jeffraines/sortbuddy/docs/build/print/belt_frame.stl

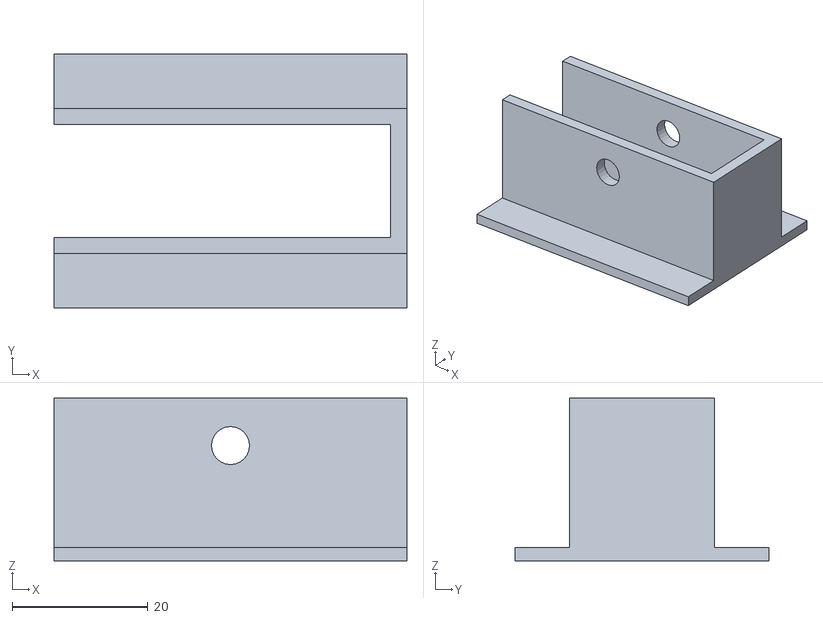
[picture p1: CAD file, 2026-11-09]
docs/build/print/belt_frame.stl
52.0 x 37.4 x 24.0
