jeffraines/sortbuddy/docs/build/print/belt_spacer.stl

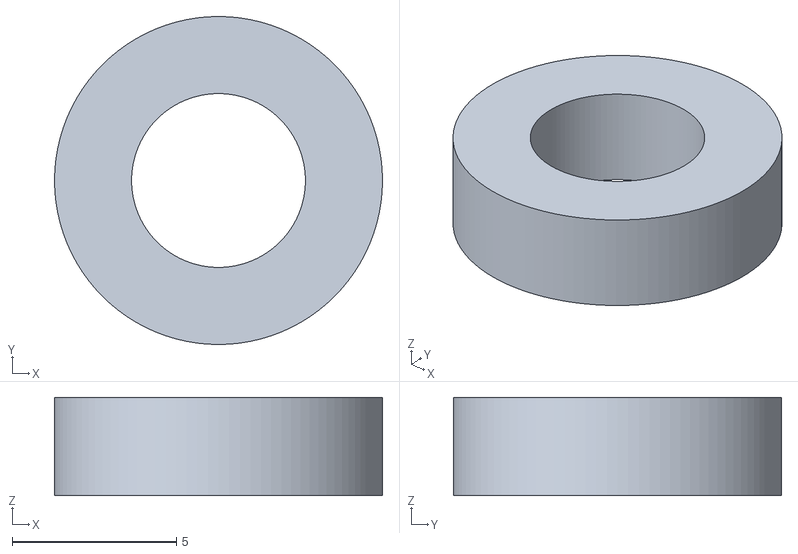
[picture p2: CAD file, 2026-11-07]
docs/build/print/belt_spacer.stl
10.0 x 10.0 x 3.00
