jeffraines/sortbuddy/docs/build/print/belt_axle.stl

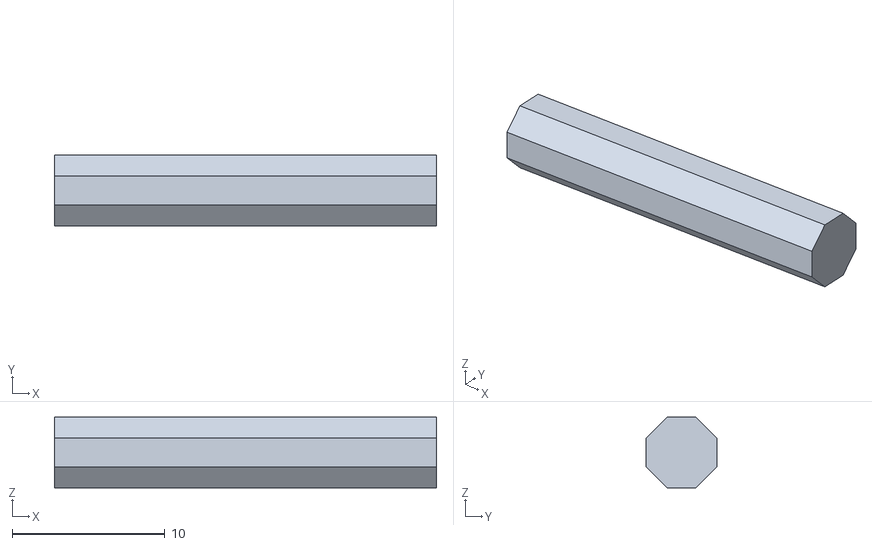
[picture p3: CAD file, 2026-11-07]
docs/build/print/belt_axle.stl
25.0 x 4.62 x 4.62
