jeffraines/sortbuddy/docs/build/print/belt_wheel_feed.stl

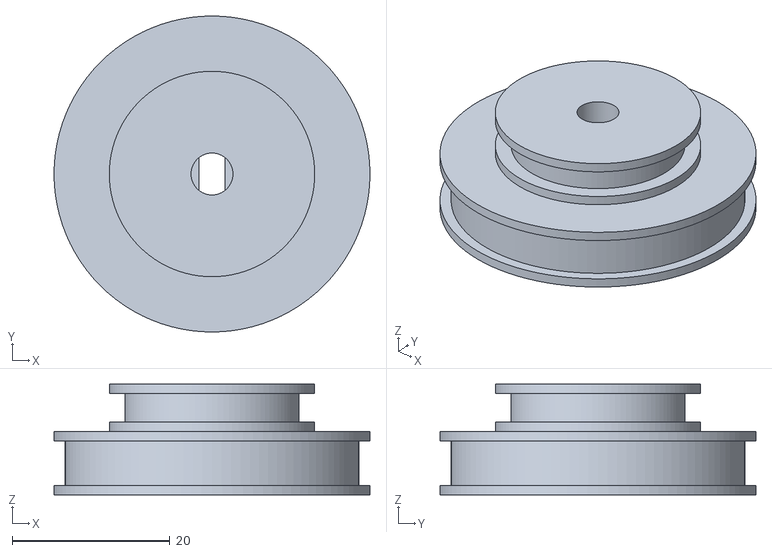
[picture p4: CAD file, 2026-11-07]
docs/build/print/belt_wheel_feed.stl
40.0 x 40.0 x 14.0
