jeffraines/sortbuddy/docs/build/print/takeaway_rollers.stl

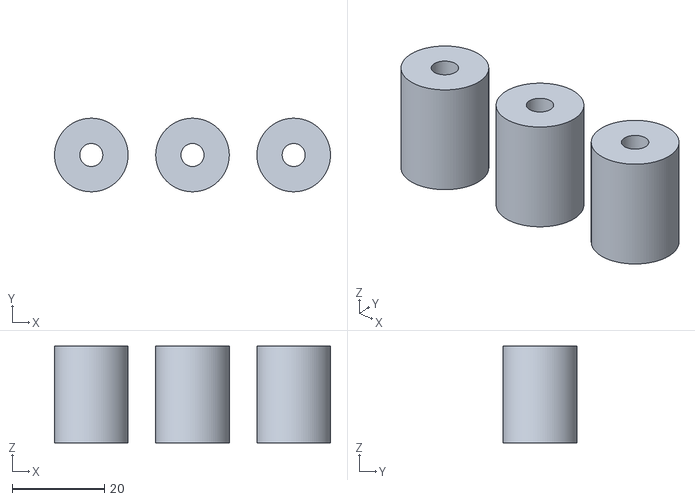
[picture p5: CAD file, 2026-11-07]
docs/build/print/takeaway_rollers.stl
60.0 x 16.0 x 21.0
