jeffraines/sortbuddy/docs/build/print/slide_takeaway_lite.stl

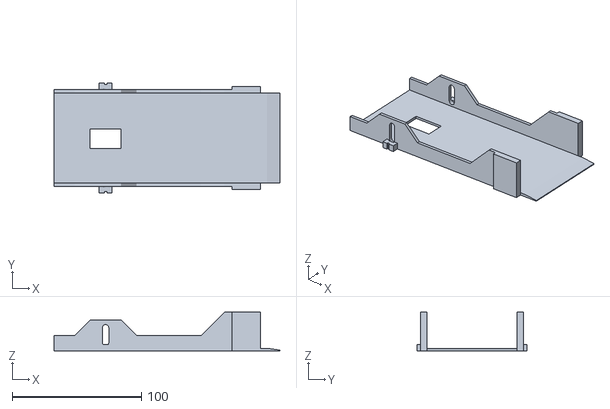
[picture p6: CAD file, 2026-11-07]
docs/build/print/slide_takeaway_lite.stl
175.0 x 84.8 x 30.0
