jeffraines/sortbuddy/docs/build/print/takeaway_bracket.stl

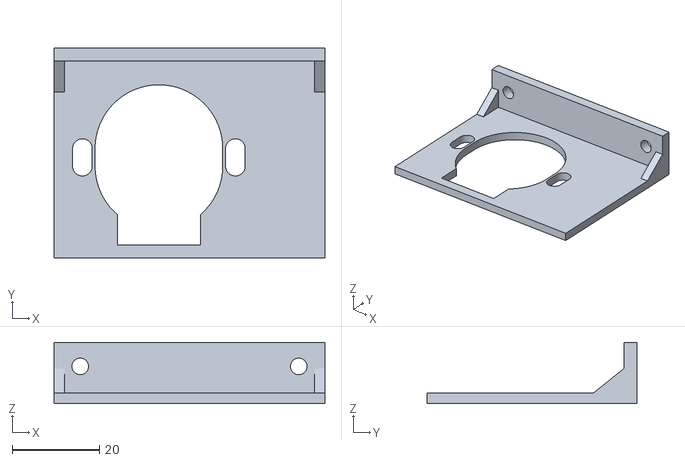
[picture p7: CAD file, 2026-11-07]
docs/build/print/takeaway_bracket.stl
62.0 x 48.0 x 14.0
