jeffraines/sortbuddy/docs/build/print/takeaway_axle.stl

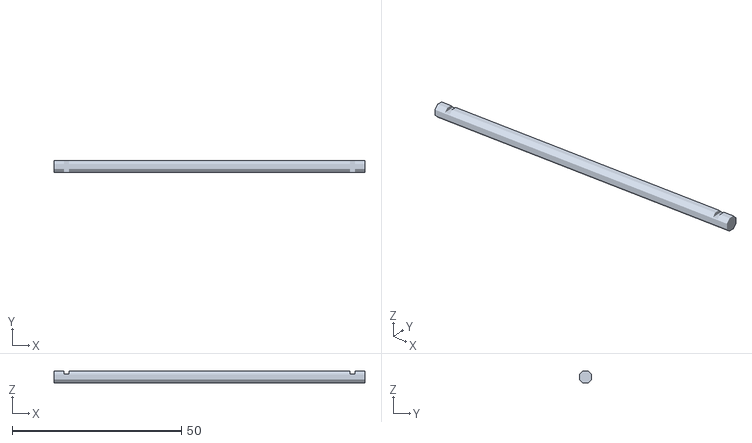
[picture p8: CAD file, 2026-11-07]
docs/build/print/takeaway_axle.stl
92.0 x 3.70 x 3.70
