jeffraines/sortbuddy/docs/build/print/takeaway_roller.stl

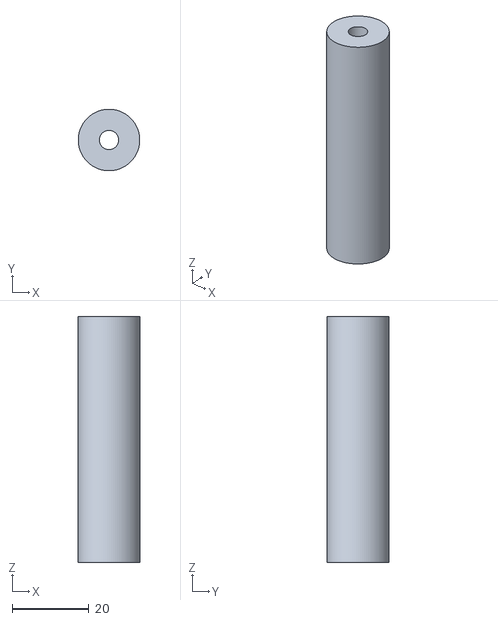
[picture p9: CAD file, 2026-11-07]
docs/build/print/takeaway_roller.stl
16.0 x 16.0 x 64.0
