jeffraines/sortbuddy/docs/build/print/bracket_lite.stl

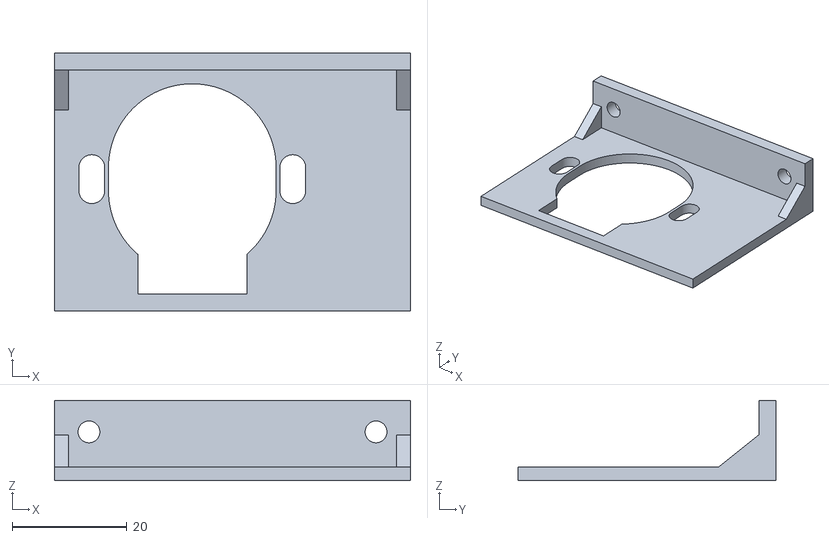
[picture p10: CAD file, 2026-11-07]
docs/build/print/bracket_lite.stl
62.0 x 45.0 x 14.0
