jeffraines/sortbuddy/docs/build/print/slide_takeaway.stl

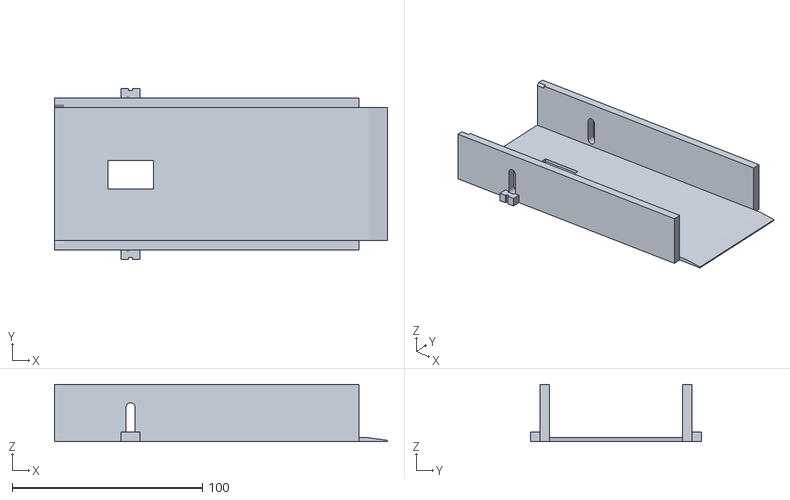
[picture p11: CAD file, 2026-11-07]
docs/build/print/slide_takeaway.stl
175.0 x 90.0 x 30.0
