jeffraines/sortbuddy/docs/build/print/hopper_frame.stl

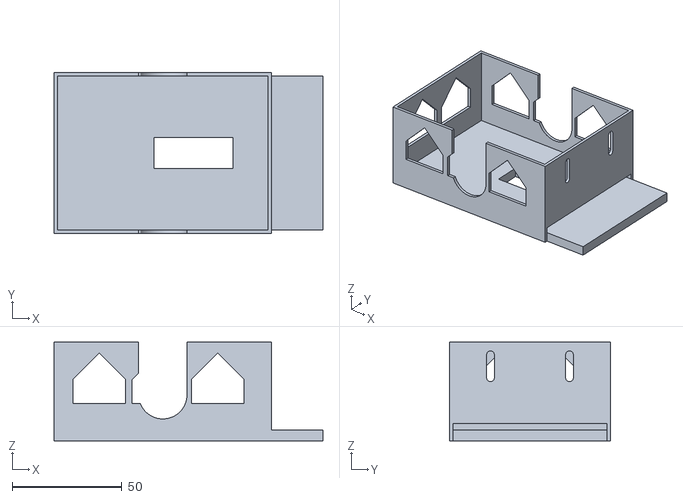
[picture p12: CAD file, 2026-11-07]
docs/build/print/hopper_frame.stl
122.6 x 73.2 x 45.0
