jeffraines/sortbuddy/docs/build/print/hopper.stl

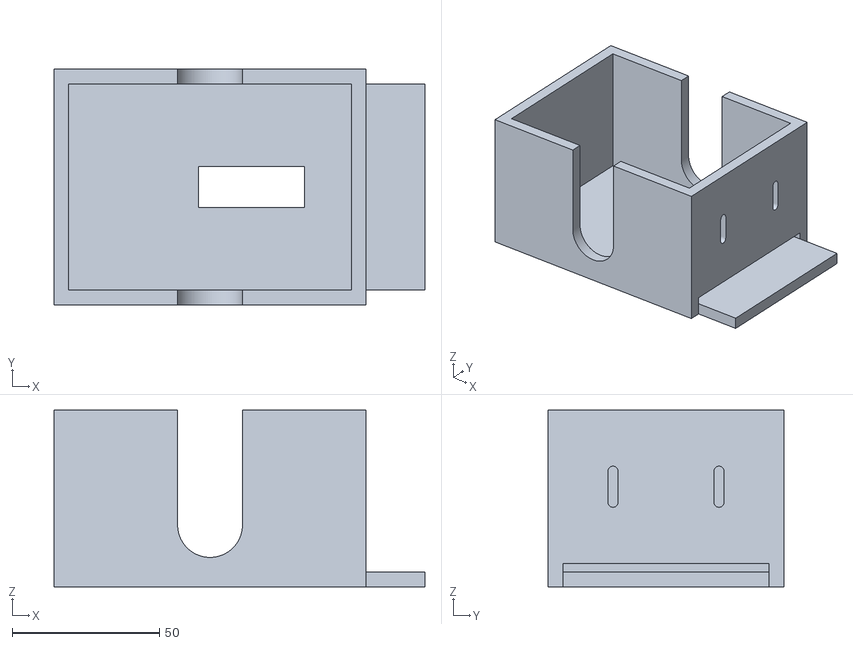
[picture p13: CAD file, 2026-11-07]
docs/build/print/hopper.stl
126.0 x 80.0 x 60.0
