jeffraines/sortbuddy/docs/build/print/hopper_light.stl

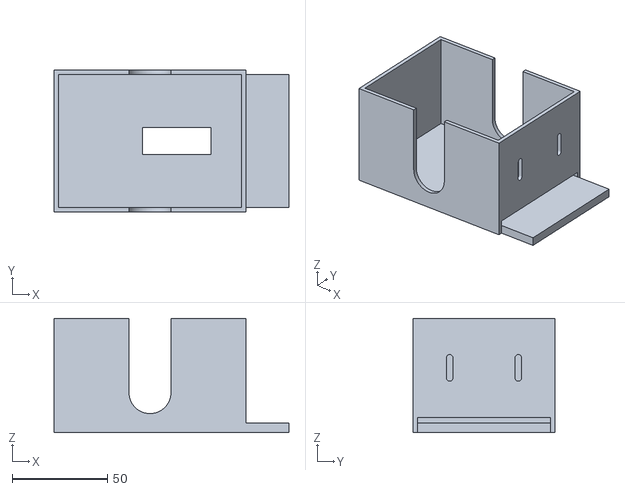
[picture p14: CAD file, 2026-11-07]
docs/build/print/hopper_light.stl
123.4 x 74.8 x 60.0
