jeffraines/sortbuddy/docs/build/print/wheel_spaced.stl

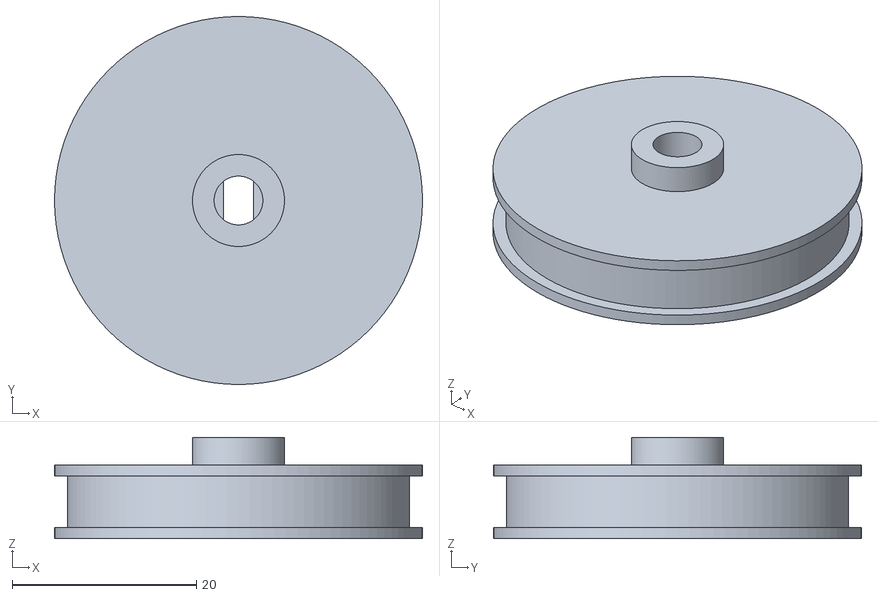
[picture p15: CAD file, 2026-11-07]
docs/build/print/wheel_spaced.stl
40.0 x 40.0 x 11.0
