jeffraines/sortbuddy/docs/build/print/wheel_lite.stl

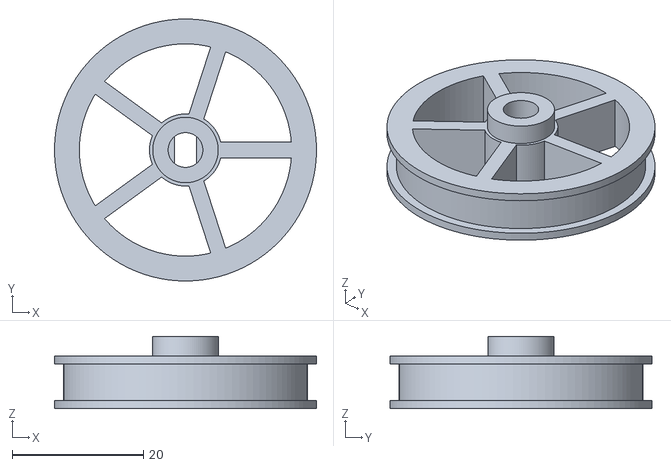
[picture p16: CAD file, 2026-11-07]
docs/build/print/wheel_lite.stl
40.0 x 40.0 x 11.0
