jeffraines/sortbuddy/docs/build/print/bracket.stl

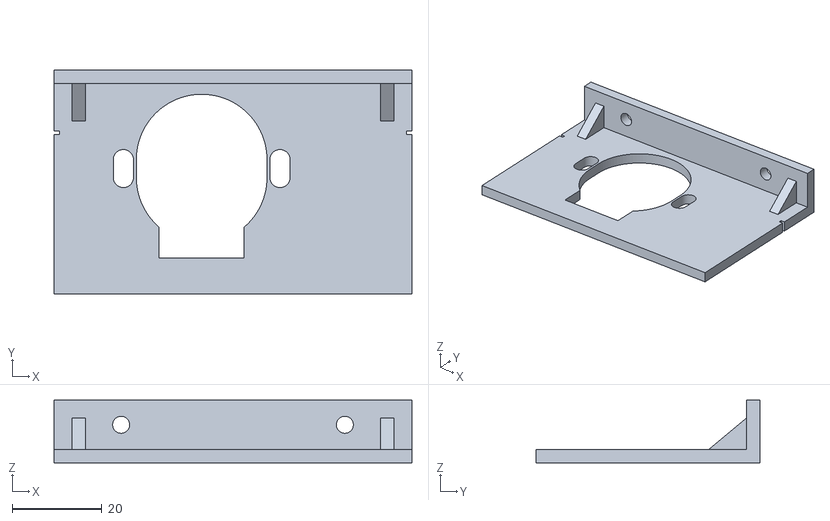
[picture p17: CAD file, 2026-11-07]
docs/build/print/bracket.stl
80.0 x 50.0 x 14.0
