jeffraines/sortbuddy/docs/build/print/panel_D.stl

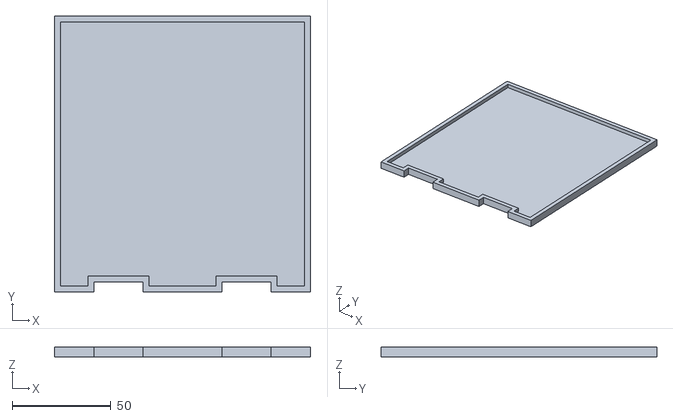
[picture p18: CAD file, 2026-11-07]
docs/build/print/panel_D.stl
130.0 x 140.0 x 5.00
