jeffraines/sortbuddy/docs/build/print/plate_F.stl

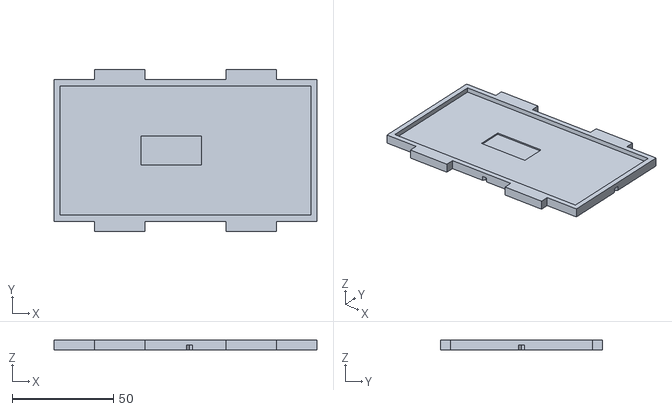
[picture p19: CAD file, 2026-11-07]
docs/build/print/plate_F.stl
130.0 x 80.0 x 5.00
