jeffraines/sortbuddy/docs/build/print/joints.stl

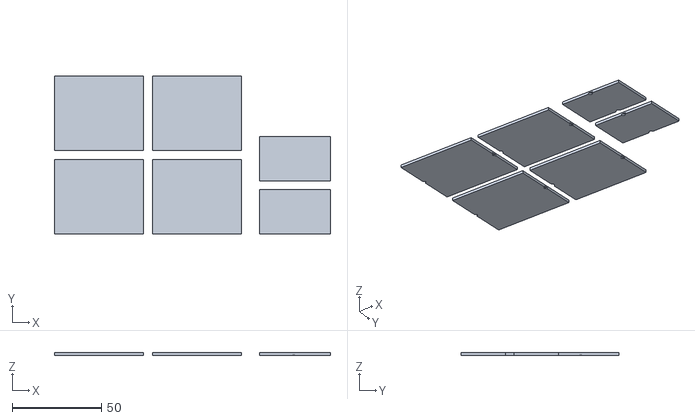
[picture p20: CAD file, 2026-11-07]
docs/build/print/joints.stl
155.0 x 89.0 x 1.60
