jeffraines/sortbuddy/docs/build/print/joiner.stl

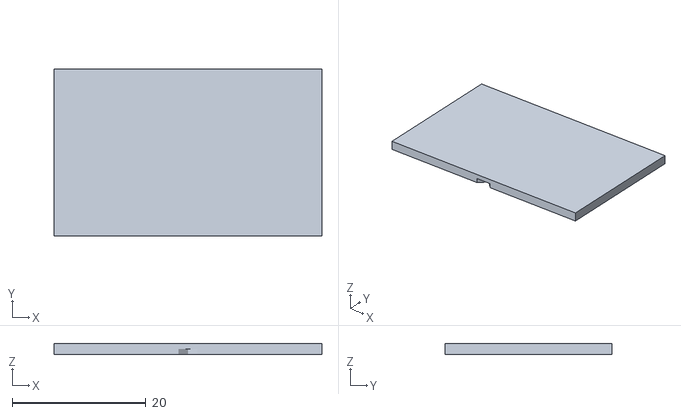
[picture p21: CAD file, 2026-11-07]
docs/build/print/joiner.stl
40.0 x 25.0 x 1.60
