jeffraines/sortbuddy/docs/build/print/splice.stl

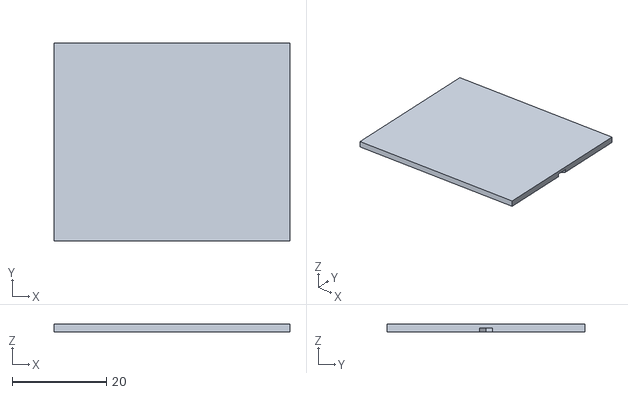
[picture p22: CAD file, 2026-11-07]
docs/build/print/splice.stl
50.0 x 42.0 x 1.60
