jeffraines/sortbuddy/docs/build/print/led_channel.stl

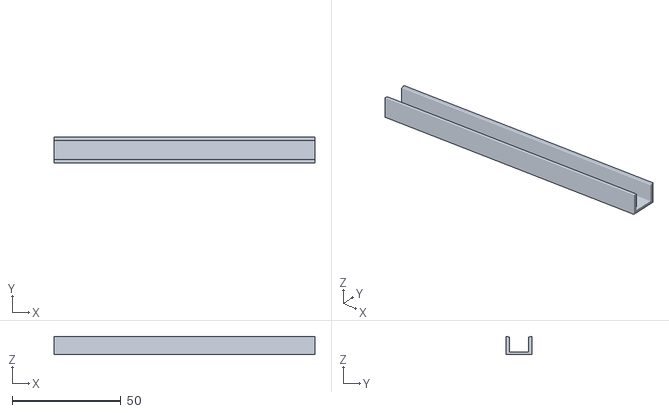
[picture p23: CAD file, 2026-11-05]
docs/build/print/led_channel.stl
120.0 x 11.8 x 8.50
