jeffraines/sortbuddy/docs/build/print/led_channel_short.stl

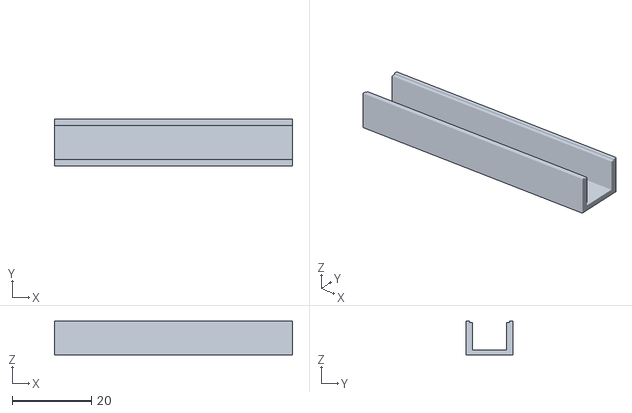
[picture p24: CAD file, 2026-11-05]
docs/build/print/led_channel_short.stl
60.0 x 11.8 x 8.50
