jeffraines/sortbuddy/docs/build/print/lower_hood.stl

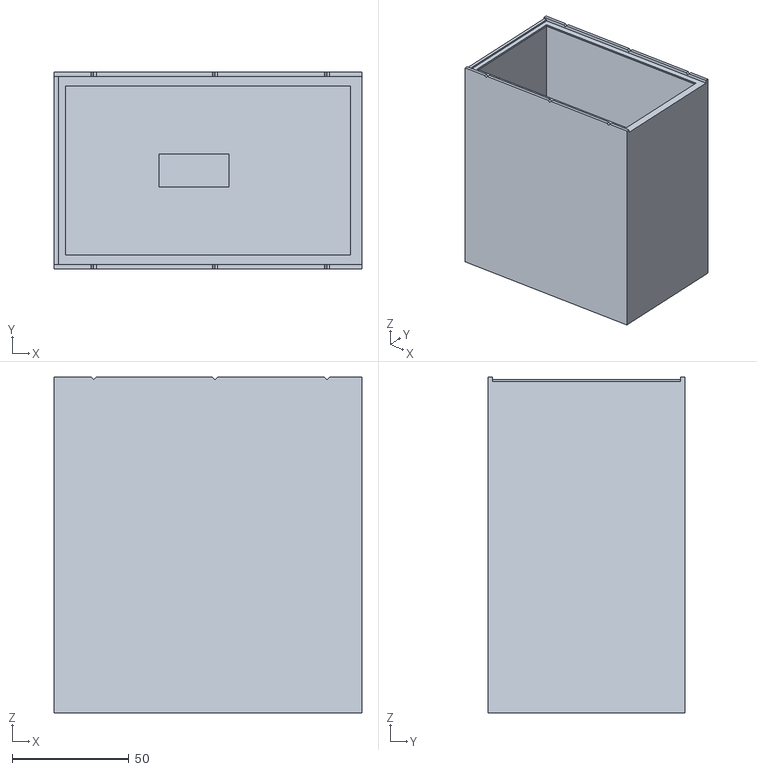
[picture p25: CAD file, 2026-11-05]
docs/build/print/lower_hood.stl
132.0 x 84.6 x 144.0
