jeffraines/sortbuddy/docs/build/print/camera_mount.stl

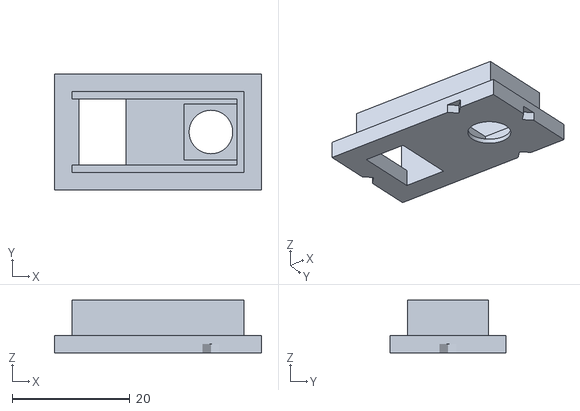
[picture p26: CAD file, 2026-11-05]
docs/build/print/camera_mount.stl
35.2 x 19.7 x 9.00
