jeffraines/sortbuddy/docs/build/print/servo_mount.stl

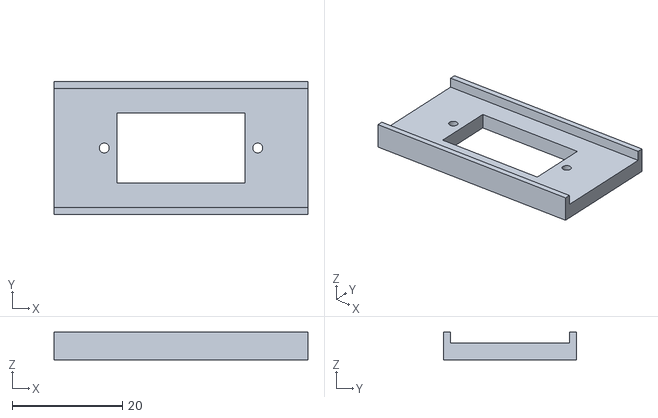
[picture p27: CAD file, 2026-11-05]
docs/build/print/servo_mount.stl
46.0 x 24.0 x 5.00
