jeffraines/sortbuddy/docs/build/print/weight.stl

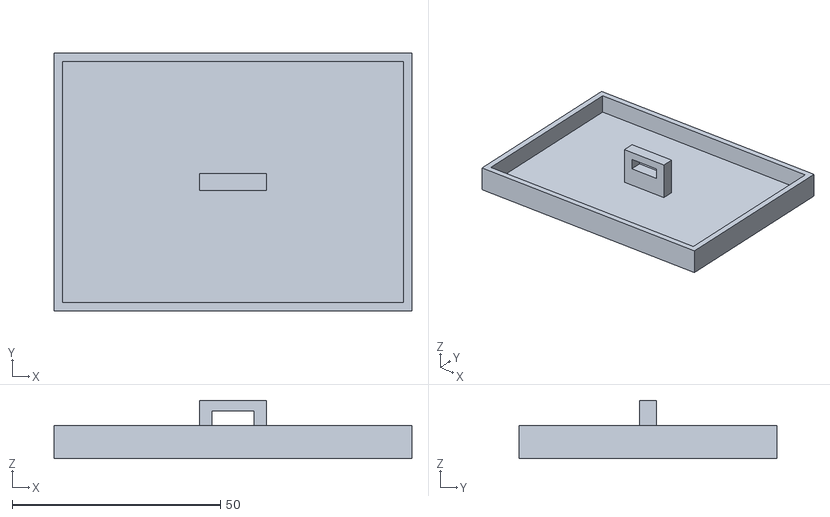
[picture p28: CAD file, 2026-11-04]
docs/build/print/weight.stl
86.0 x 62.0 x 14.0
