jeffraines/sortbuddy/docs/build/print/slide.stl

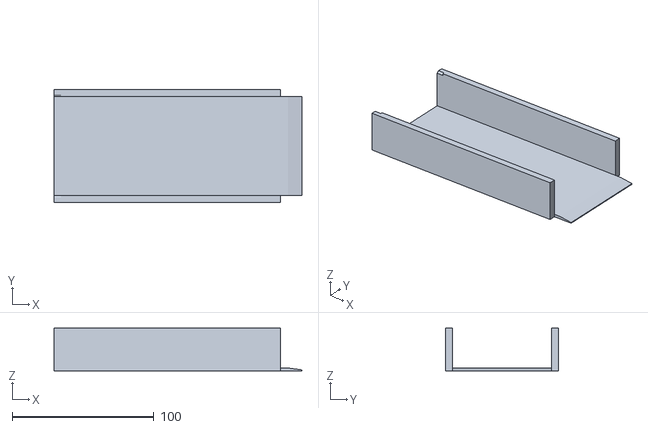
[picture p29: CAD file, 2026-11-04]
docs/build/print/slide.stl
175.0 x 80.0 x 30.0
