jeffraines/sortbuddy/docs/build/print/throat.stl

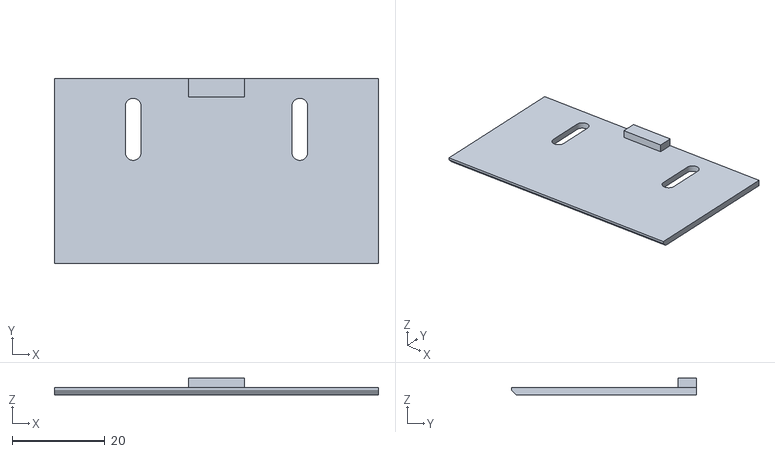
[picture p30: CAD file, 2026-11-04]
docs/build/print/throat.stl
70.0 x 40.0 x 3.60
