jeffraines/sortbuddy/docs/build/print/wheel.stl

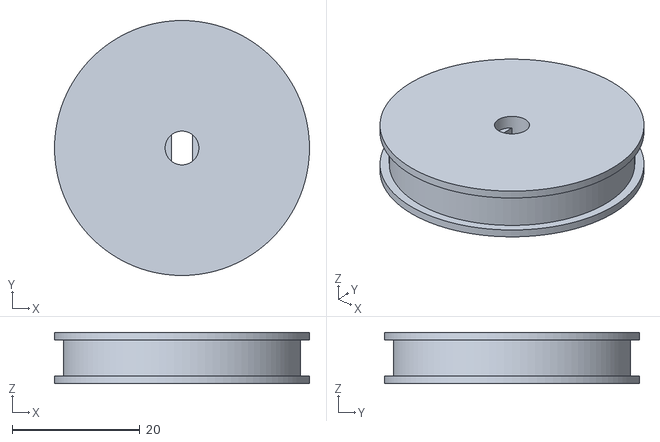
[picture p31: CAD file, 2026-11-04]
docs/build/print/wheel.stl
40.0 x 40.0 x 8.00
