jeffraines/sortbuddy/docs/build/print/wheel_big.stl

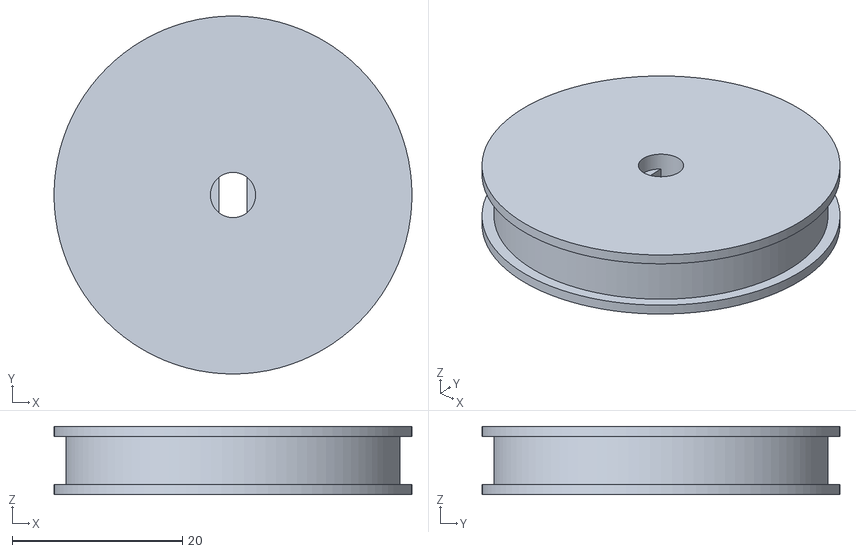
[picture p32: CAD file, 2026-11-04]
docs/build/print/wheel_big.stl
42.0 x 42.0 x 8.00
