jeffraines/sortbuddy/docs/build/print/flap.stl

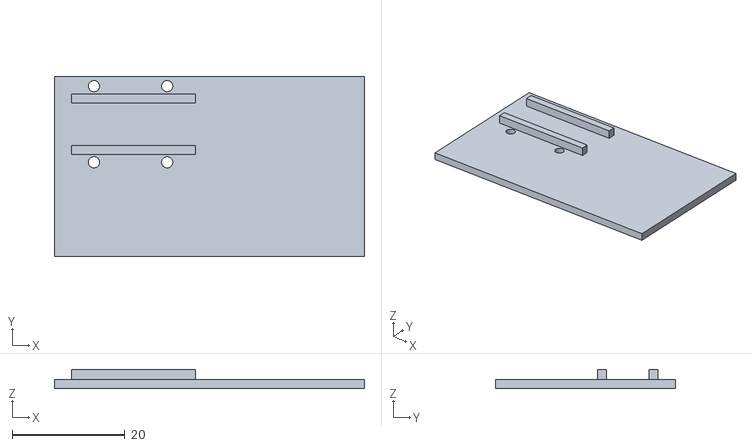
[picture p33: CAD file, 2026-11-04]
docs/build/print/flap.stl
55.0 x 32.0 x 3.40
