jeffraines/sortbuddy/(list of files, cad)

Other CAD files:
docs/build/print/belt_wheel_takeaway.stl
docs/build/print/plate_E.stl
