jeffraines/sortbuddy/docs/build/foam-template.pdf

SortBuddy scan station: how to use this template | page 1 / 10 · 5 mm foam board · print at 100%

### Print

Print at 100% / 'Actual size' (NOT 'Fit to page'). Measure the 50 mm square: if it isn't 50 mm, fix the print setting.

### Cut

Tape each page lightly onto the foam board, cut through paper and foam with a FRESH blade, 2-3 light passes. Black solid lines = cut. Crossed boxes = cut out (holes). Dashed = guides, don't cut.
Notches are exactly 5 mm (the board thickness): cut on the inside of the line so the tabs fit snug.

### Assemble (glue only on the OUTSIDE; nothing sticky where cards slide)

1. Lower hood: panels D1 + D2 stand upright, bottom plate F's tabs in their notches.
2. Window: acrylic 80 x 130 across the top edges of D (thin double-sided tape on those edges).
3. Upper hood: panels C1 + C2 on the acrylic, right above D; top plate E's tabs in their notches. Splices H (x4) on the outside across the C/D seam hold the hoods and the acrylic together.
4. Slide: walls B onto floor A (tabs in notches). Tape or plastic sheet on the floor's top.
Its end slides between C1 and C2 onto the acrylic (15 mm). Joiners J outside, wall to panel.
5. Gate: servo through C1's cutout from outside, horn inside. Flap G glued to the horn.
Set 'closed' in the control panel so the flap's edge just touches the window.
6. Cameras: top board on E, lens down through the hole; bottom board on F, lens up.
Long side of the picture along the channel. Hot glue the board corners only, never the lens.
7. Stand: wedges K on base L, lower hood on the wedges, tall end under the slide.
8. Light: LED strip inside the upper hood around the camera, covered with tissue or paper.
In the lower hood put it along the side walls, not next to the camera (glare off the acrylic).
9. Hopper (pages 9-10): walls P2-P5 around floor P1. Motor on bracket Q under the floor, wheel W (rubber bands round its rim) poking ~1 mm up through the slot. Strip T on the front wall sets the gap to ~1.5 cards. The floor's lip rests 20 mm onto the top of the slide.

slide (A + B)

top camera (on E)

upper hood C + E

lower hood D + F

bottom camera

acrylic window

gate G

card out

Side view, not to scale. The whole thing stands tilted 30° on wedges K.

# 50 mm

measure me

Parts (5 mm foam):
A slide floor x1
B slide walls x2
C1, C2 upper hood
D1, D2 lower hood
E top plate
F bottom plate
G gate flap
H splices x4
J joiners x2
K wedges x2
L base
M, N sorter (later)
P1-P5 hopper
Q motor bracket
R braces x2
S weight, W wheel x2
+ acrylic 80 x 130
+ plastic strip T

Card: 63 x 88 mm (sleeved ~66 x 91). Channel 70 mm. Cameras 130 mm from the window, centred where the card stops against the gate.

SortBuddy scan station: slide, gate flap, joiners | page 2 / 10 · 5 mm foam board · print at 100%

## A Slide floor x1

Cover the top with packing tape or a clear file-folder sheet. Tabs go into the notches of walls B.

card travels

on the
window

sand a
bevel

walls end

## B1 Slide wall (make 2)

notched edge = bottom, flush with the floor's underside

hood end

## B2 Slide wall (make 2)

notched edge = bottom, flush with the floor's underside

hood end

### G Gate flap x1

Glue the servo horn on the blue box; bottom edge just touches the window.

J Joiner x2

wall B | panel C

outside, over the joint

J Joiner x2

wall B | panel C

outside, over the joint

SortBuddy scan station: upper hood panels | page 3 / 10 · 5 mm foam board · print at 100%

## C1 Upper hood, GATE side

Notched edge = top (top plate E goes there). Straight edge = bottom, sits on the window.

slide end | gate end

camera line

Cut out: the gate servo goes through from outside, tabs on the outside face, shaft on the + (if your servo's shaft is at the other end, flip
the hole).

flap

## C2 Upper hood, plain side

Notched edge = top (top plate E goes there). Straight edge = bottom, sits on the window.

slide end | gate end

camera line

SortBuddy scan station: lower hood D1, top plate E page 4 / 10 · 5 mm foam board · print at 100%

## D1 Lower hood panel (make 2)

Straight edge = top, the window rests on it.
Notched edge = bottom (bottom plate F goes there).
slide end | gate end

## E Top plate

Camera board on top, lens down through the hole (cut it to your lens).
Tabs go into the C notches.

gate end

SortBuddy scan station: lower hood D2, bottom plate F page 5 / 10 · 5 mm foam board · print at 100%

## D2 Lower hood panel (make 2)

Straight edge = top, the window rests on it.
Notched edge = bottom (bottom plate F goes there).
slide end | gate end

## F Bottom plate

Camera board inside, on this square, lens pointing up at the window.
Tabs go into the D notches.

gate end

SortBuddy scan station: base and splices | page 6 / 10 · 5 mm foam board · print at 100% L Base x1 Glue wedges K on the dashed lines ⁽outside faces 80 apart). | Tall end of the wedges = slide end.

H Splice (make 4)

upper panel C

window edge

lower panel D

glue on the OUTSIDE

H Splice (make 4)

upper panel C

window edge

lower panel D

glue on the OUTSIDE

H Splice (make 4)

upper panel C

window edge

lower panel D

glue on the OUTSIDE

H Splice (make 4)

upper panel C

window edge

lower panel D

glue on the OUTSIDE

SortBuddy scan station: stand wedges | page 7 / 10 · 5 mm foam board · print at 100%

## K1 Wedge 30° (make 2)

30° | the lower hood sits on the long slope

## K2 Wedge 30° (make 2)

30° | the lower hood sits on the long slope

SortBuddy scan station: acrylic window, sorter (later) page 8 / 10 · 5 mm foam board · print at 100%

## ACRYLIC window

80 x 130 from 2 mm acrylic

Lay the acrylic on this
and mark it. Score 10-15x
with a knife, snap over
the table edge.

gate

slide floor ends here

slide end

### M Sorter flap (later)

Cards land here after the gate. Servo horn under the blue line: tilt left = YES, right = NO, level = straight on to ?

N Servo holder (x2, later)

two layers glued together

N Servo holder (x2, later)

two layers glued together

SortBuddy scan station: hopper floor and side walls page 9 / 10 · 5 mm foam board · print at 100%

## P1 Hopper floor x1

Tape or plastic sheet on top (not over the slot).

wheel slot

bracket Q goes UNDER the floor here

back

front

lip:
rests on
the slide

## P2 Hopper side wall

Glued against the floor's edge (grey band = floor). Back wall at the left, front wall at the right,
its bottom 3 mm above the floor (the throat).

throat

## P3 Hopper side wall

Glued against the floor's edge (grey band = floor). Back wall at the left, front wall at the right,
its bottom 3 mm above the floor (the throat).

throat

wheel W turns, the bottom card goes out

weight S

strip T: gap ~1.5 cards

to the slide

Side view, not to scale. The strip lets one card under and holds the next one back.

SortBuddy scan station: hopper walls, wheel, motor bracket page 10 / 10 · 5 mm foam board · print at 100%

### P4 Back wall

stands on the floor,
between the side walls

### P5 Front wall

bottom edge 3 mm above the floor

slots: M3 screws for strip T

Q Motor bracket x1

shaft

Top edge under the floor (blue line on P1). Motor's flat front on THIS side, body through the big hole. M3 screws in the tabs.

W Wheel

make 2,
glue together

W Wheel

make 2,
glue together

### S Stack weight

Sits on top of the cards
so the last few still
press on the wheel.
Tape coins on top
(about 30-50 g).

T Throat strip (PLASTIC)

file-folder sheet or acrylic offcut; screwed on the front wall's outside.

Bottom edge = the gap: ~1.5 cards.

R brace x2 | R brace x2
