jeffraines/sortbuddy/docs/build/belt-drive.png

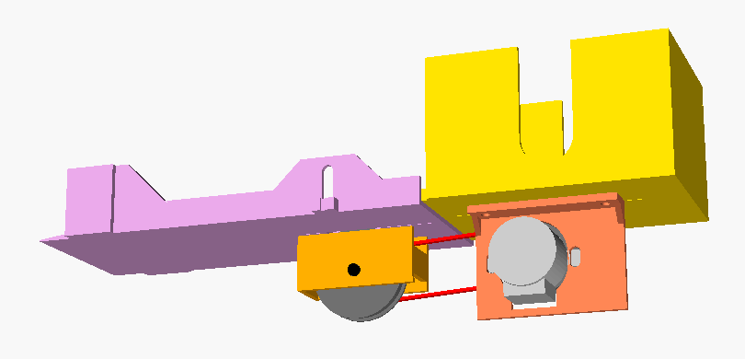
docs/build/belt-drive.png
