jeffraines/sortbuddy/docs/build/feeder-exploded.png

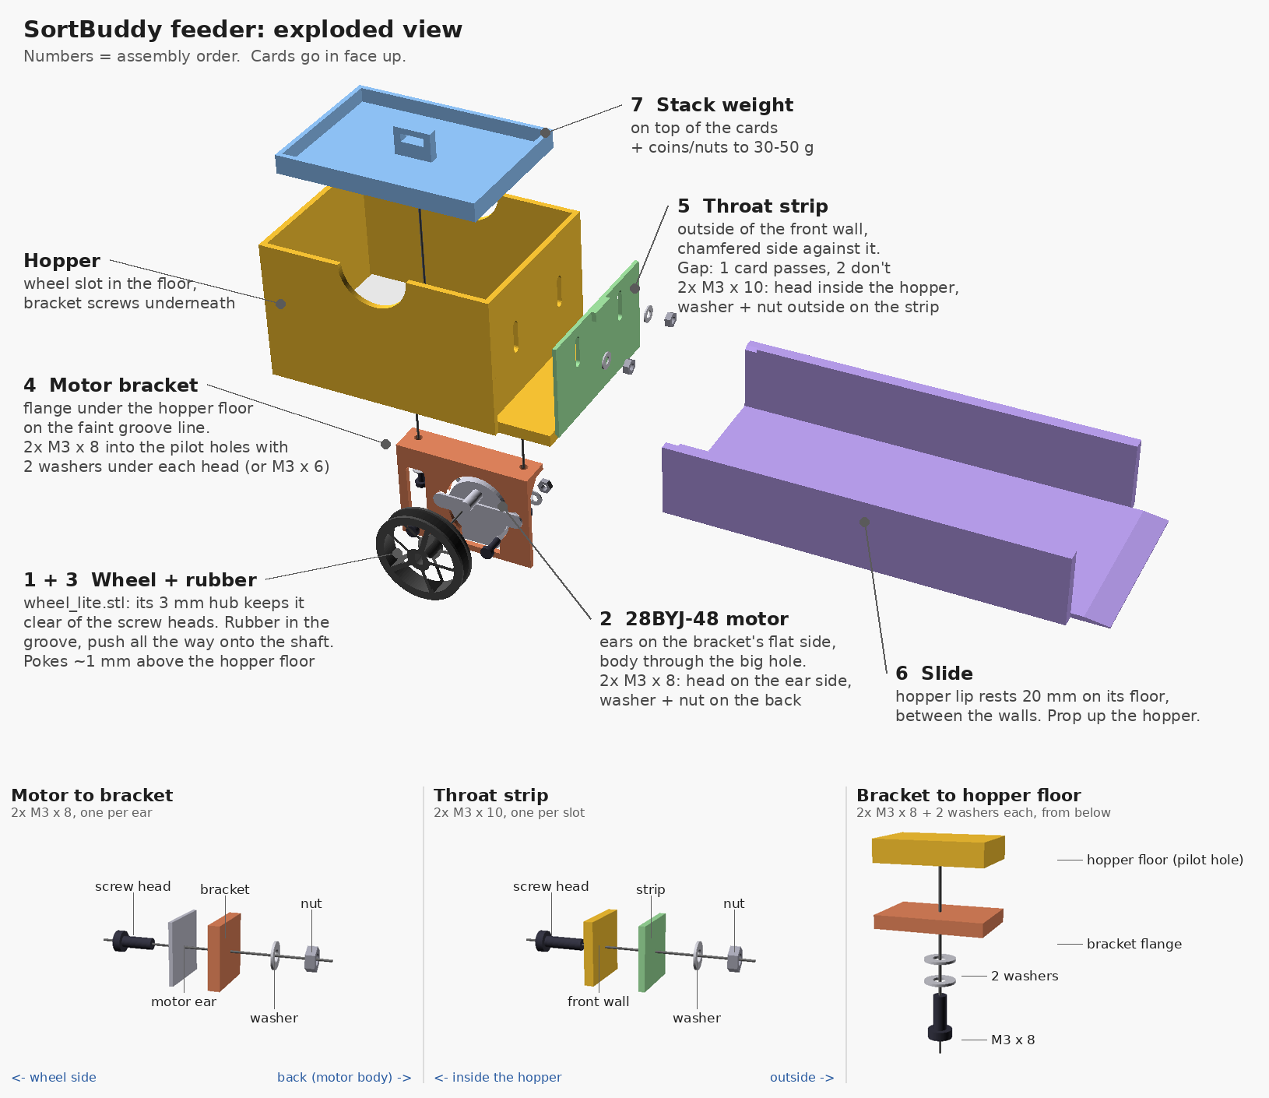
docs/build/feeder-exploded.png
