jeffraines/sortbuddy/docs/build/roller-band.png

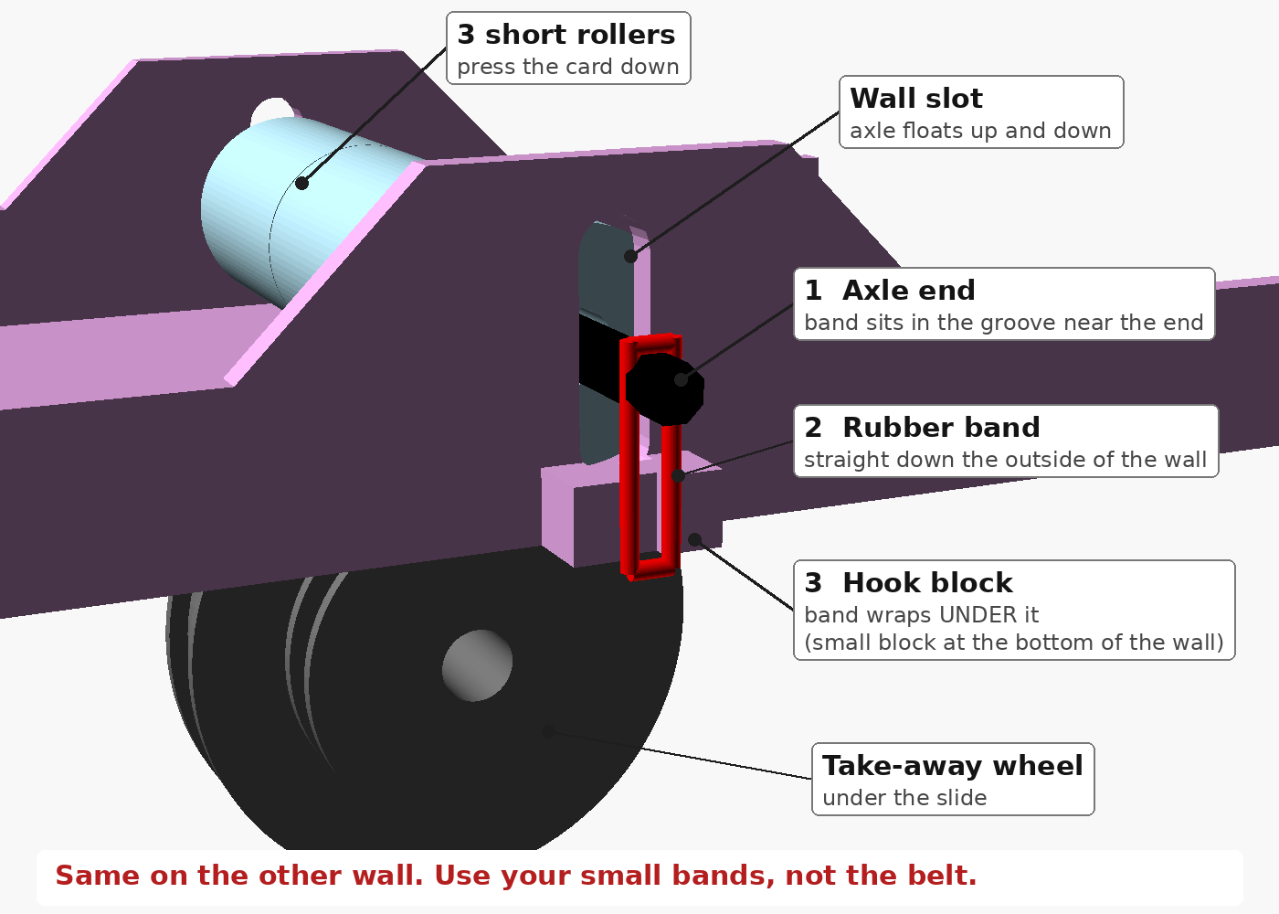
docs/build/roller-band.png
