jeffraines/sortbuddy/(commit log)

2026-10-11 Add webcam prototype for a two-pile TCG bulk sorter
    Phase 0 of SortBuddy: identify cards held up to a webcam, answer a yes/no
    sort rule, log scans, and export an inventory CSV.
    - vision: find and perspective-flatten the card in a frame
    - fingerprint: 256-bit DCT perceptual hash index, handles upside-down cards
    - catalog/rules: sort parameters are catalog lookups, rules like 'cost <= 3'
    - radix: multi-pass full sorts on a two-pile machine (binary LSD radix)
    - session: per-card debouncing, logs, inventory export
    - demo: generated fake card set so everything runs without real data
    - docs/DESIGN.md: feeder, camera station, diverter, electronics, roadmap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
2026-10-11 Add enroll command: build references from your own webcam photos
    Hold each card up to the webcam and press space; the flattened photo
    becomes that card's reference image and the catalog CSV/JSON is created
    or updated, then the index is rebuilt. If the catalog already lists
    cards without photos, enroll prompts for each by name.
    Also keep CSV ids as text, add Catalog.save, and document the Windows
    webcam quick start and that the device only needs fingerprints.
    Claude-Session: https://claude.ai/code/session_01Ks1AJqX4KiWSXEghkQfdCQ
2026-10-11 Open webcams with DirectShow on Windows; add 'cameras' command
    OpenCV's default Media Foundation backend can hang indefinitely (and
    ignore Ctrl+C) opening some USB webcams on Windows. DirectShow opens
    them reliably. 'sortbuddy cameras' lists which --camera numbers work.
    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
2026-10-11 Use the webcam at 1080p with manual focus; read card names with OCR
    Camera:
    - Open at 1920x1080 MJPG instead of OpenCV's 640x480 default
    - Manual focus: [ and ] adjust live, A returns to autofocus, --focus N
    to start at a known setting (autofocus tends to lock onto the table)
    - Find the card on a downscaled frame, cut it from the full-res frame
    - Window scaled to fit the screen
    Enroll:
    - After SPACE, OCR (optional rapidocr_onnxruntime) reads the name and
    set code/collector number; the window shows them and ENTER saves,
    TAB cycles name guesses, E types in the terminal, ESC discards.
    No more switching to the terminal for every card.
    - Handles upside-down cards, OCR dropping spaces, an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
2026-10-11 Add a window app and double-click launcher, no terminal needed
    - sortbuddy/gui.py: Tk window to pick the card list and camera, add
    cards, enter a sort rule, start sorting, open the list in Excel and
    export inventory; remembers settings; shows command output in a log.
    Runs the same CLI commands in-process; the camera window is unchanged.
    - SortBuddy.bat: first run creates the venv and installs everything
    (with OCR), then opens the app with pythonw (no console window).
    - sortbuddy-gui entry point; 'type it in' uses a dialog in the app.
    - enroll: explain instead of crashing when Excel has the CSV locked.
    Claude-Session: https://cl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
    [cli.py, gui.py]
2026-10-11 Fix set/number reading; look up Magic card details on Scryfall
    OCR collector info: only consider the bottom-left corner, skip prose
    (flavor text, artist, copyright), match set codes case-sensitively and
    prefer the line with a language code, ignore power/toughness like 3/2
    and years. Divining Duelist now reads FRA-029 instead of THEY-003.
    Enroll --lookup mtg (or 'Card details from' in the app) fetches the
    card from Scryfall after OCR and stores set, number, rarity, cost, mana
    cost, colors, types, subtypes, power/toughness, keywords, rules text,
    artist, year and price. Unconfirmed printings (set not read) are
    flagged. New rule operator: 'contains' for text.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
    [cli.py, demo.py, gui.py, lookup.py, ocr.py, rules.py]
2026-10-11 Read the foil mark from Magic's bottom line
    'LCI ★ EN' means foil, 'LCI • EN' non-foil. Enroll shows it, saves
    foil=yes/no, and uses the foil price for foil copies. Left empty when
    the mark wasn't read (older cards, or OCR missed it).
    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
    [cli.py, ocr.py]
2026-10-11 Fix set code when OCR merges the rarity or artist into collector lines
    Real OCR of Divining Duelist gave 'C0029' (no space) and put the
    small-caps artist on the 'FRA•EN' line in mixed case. The set became
    C002 (from C0029) and the FRA line was dropped as prose.
    - Lines with a language code are never treated as prose
    - Digits running into a number are stripped from set codes (C0029 -> C)
    - Codes right before the language code (FRA • EN) score highest
    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
    [ocr.py]
2026-10-11 One-window app; Riftbound lookup via Riftcodex
    App (gui.py) rewritten as a single window: camera view embedded (no
    separate OpenCV windows), closing the window always stops the camera,
    opens maximized (F11 full screen), dark layout. Right panel shows the
    information pulled from the captured card (rows appear for the parts
    the card has: mana cost, energy/power/might, type, domain/colors, rules
    text, P/T, set, number, rarity, variant, foil, artist, year, price), with
    editable name/id and Save/Discard/Next guess/Look up buttons; while
    sorting, a big YES/NO, counts, recent cards and Undo. OCR and lookups run
    in a background thread so the camera never freezes. Lookup defaults on.
    - lookup.riftco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
2026-10-11 Read Korean card names with a Korean OCR model
    When the bottom line says KR, read the card again with RapidOCR's
    PP-OCRv5 Korean recognition model and save the printed name as name_kr
    alongside the English name from the lookup (or as the name, if lookup
    is off). The 13 MB model downloads once into ~/.sortbuddy/models on the
    first Korean card and is checked against a pinned SHA-256. The app
    shows it as 'Name on card'.
    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
2026-10-11 Sort without enrolling first: identify from the bottom line, learn as you go
    - identify.Identifier: picture match against your list first; else OCR
    only the bottom strip (~0.15 s, both orientations) for set + number and
    look it up; else full OCR + name lookup. New cards are added to the
    list with their photo and fingerprint, so repeats are instant.
    - ocr.read_collector with a strip-tuned engine (the default one upscales
    the short side to 736 px, making strips slow). Foil check limited to
    Magic's 'SET * EN' layout (Riftbound dots are separators).
    - lookup: whole-set card lists from Scryfall/Riftcodex cached on disk
    (~/.sortbuddy/cache, refreshed weekly); set+number lookups are loc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
    [fingerprint.py, gui.py, identify.py, lookup.py, ocr.py, rules.py]
2026-10-11 Rule builder, card backs, camera controls, and guards against misreads
    Rule builder: pick field + how to match (choices with tick boxes, numbers,
    text) instead of typing; plain-English preview and how many cards in your
    list match; advanced typing still available. New rule ops: 'not in', and
    'contains' with | alternatives. Fields include Game and Face up or down.
    Riftbound domains are also saved as colors (Mind = blue, ...); Domain only
    offered when Riftbound is chosen. Lookups set game=magic/riftbound.
    Card backs: 'This is a card back...' teaches a game's back; recognised
    from its picture without reading, face=back, game=... Lets you split face
    up / face down or sort a mixed box by game. E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
2026-10-11 Faster sorting for simple rules; fix focus search; camera speed; stricter overlap check
    - Rules that only need what the bottom line shows (game, set, number,
    language, foil, face) are answered from the set code: no lookup, no
    whole-card read. Sorting skips the Korean-name pass. The status line
    shows how long each step took when a card takes over a second.
    - Find best focus no longer needs the card outline (at bad focus it
    can't be found, which left it stuck): measures the middle of the picture
    then, can be stopped by clicking again, times out after 40 s, and
    sorting pauses while it runs (moving focus looked like new cards).
    - Focus arrow buttons (steps of 5, the C920's step).
    - C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
    [camera.py, gui.py, identify.py, ocr.py, vision.py]
2026-10-11 Find the top card in stacks and overlaps instead of refusing
    The overlap guard blocked real use: a stack of cards in a box never looks
    like one card from outside. Now outlines inside the pile are searched too
    (contour tree) and the largest clean card shape that's a good part of the
    pile is taken: that's the top card. Edges are thickened less, so the top
    card's edge doesn't merge with the cards under it.
    Simulated (cards on a light box floor): top card found and recognised in
    100/100 singles, 94/100 messy stacks (the other 6 not confident, so the
    bottom line decides), 100/100 overlapping pairs, 0 confidently wrong.
    ~6 ms per frame.
    With no clean outline the card is still identified in 'care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
    [gui.py, identify.py, vision.py]
2026-10-11 Light meter, glare highlighting, exposure control, calibration and self-tuning
    - lighting.assess: judges a card's light (washed-out share, brightness,
    one glare spot vs spread out) -> good / bright / glare / dark with a
    plain message; shown live in the sidebar. Without a card outline (very
    bright light washes it out too) the middle of the picture is judged.
    - Washed-out parts of the card are painted red on the video.
    - Exposure: Auto or manual (DirectShow power-of-two seconds) with arrows
    and slider, saved in settings.
    - 'Calibrate camera' replaces 'Find best focus': exposure sweep (most
    contrast, penalised for washed-out pixels) then the focus sweep; stores
    the calibrated sharpn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
    [camera.py, gui.py, lighting.py]
2026-10-11 Fix crash when pressing Calibrate before the camera is started
    Camera state (sweep, frame, track...) was only created when the camera
    started, so Calibrate camera with the camera off raised AttributeError.
    Set it up at launch; every button and shortcut checked with the camera off.
    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
    [gui.py]
2026-10-11 Fix repeat counting, the box being taken for a card, window jumping, slow start
    Real-use fixes from sorting out of a box:
    - Card finding: shapes over half the picture (a box floor) or running off
    its edge (box walls, hands) are never the card; outlines must be straight
    (a stack's outline has steps where cards underneath stick out). Simulated
    box: empty box 40/40 no card (was 37/40 'card'), single card 50/50,
    stack 50/50 top card; table stacks/overlaps 100%. ~10-13 ms per frame.
    - One decision per card: it counts again only after the view is empty for
    1 s, or a clearly different card holds steady; the same card id is never
    counted twice in a row without being taken away. Simulated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
    [gui.py, identify.py, lookup.py, ocr.py, vision.py]
2026-10-11 Wrap camera info text in the fixed-width sidebar
    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
    [gui.py]
2026-10-11 Steadier card outline, new card on top detected, cards in a box, overhang trim
    - Stabilizer: smooth the outline over frames, hold through brief dropouts,
    switch only after a new outline is consistent for a few frames
    - A card in a tight box: prefer the clean outline inside the box opening,
    but not a card's own art box (lopsided margin)
    - Trim an outline made too long by a card sticking out underneath: cut
    where the end looks like the card's own sides
    - New card placed on top without a gap counts as a new card
    - Fixed-height camera/light labels so the sidebar stops redrawing
    Claude-Session: https://claude.ai/code/session_01Ks1AJqX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
    [gui.py, vision.py]
2026-10-11 Recheck after any movement; don't crop to a card's own printed frame
    - Movement in the picture (a hand, a card dropped in) followed by half a
    second of stillness makes SortBuddy look at the card again. The same
    card (or the same unknown card) is never counted twice. Identification
    also waits for the picture to settle.
    - A thin even margin between two outlines is the card's border and printed
    frame, not a card lying in a box: keep the outer outline (dark-bordered
    cards in a box cropped right 25-30/30, was 6-17/30)
    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
2026-10-11 Find cards with broken edges, close cameras; card photos; rotate view
    - Card outline from straight lines when the edge is broken (soft focus, a
    dark card underneath): four lines making a card-shaped rectangle
    - Also find a card as one dark shape (black borders in a white box)
    - A card may fill up to 85% of the picture (close camera); an empty box
    floor is rejected because it has no print on it
    - Inner rectangles (art box, printed frame) aren't taken for the card
    - Clipping detection that works for webcams that clip below 255, so
    calibration doesn't favour overexposed settings
    - Optional: save a photo (630x880 JPEG) of each sorted card
    - Button to rotate the on-screen view
    Co-Authored-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
    [gui.py, lighting.py, vision.py]
2026-10-14 Local US price history from TCGCSV, risers and comeback flags
    - 'Update prices' / 'sortbuddy prices update': one daily snapshot of
    TCGplayer prices (via TCGCSV) for One Piece, Riftbound, Pokemon (EN/JP)
    and Magic into ~/.sortbuddy/prices.db; history grows from day one
    - Cards matched by game, set and number; cheapest and dearest printing
    with that number (normal vs parallel / alt art)
    - 'prices movers': biggest 7/30-day risers, optionally under a price, with
    a comeback flag (flat or falling for two months, then +30%)
    - 'prices report': price, value and trend of the cards you own
    - Listings use these prices when the card has none, and warn when a
    parallel / alt art with the same num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
2026-10-24 Raspberry Pi hardware: servos, stepper, camera check, wiring and setup guides
    - hardware.py: gate and tray servos on GPIO18/19 (hardware PWM via sysfs
    with the pwm-2chan overlay, gpiozero fallback), 28BYJ-48 stepper on
    GPIO17/27/22/23, a Machine with the safe order (feed only when the tray is
    level and the gate closed), and a fake board for testing off the Pi
    - 'sortbuddy hw cameras|servo|stepper|cycle' to test each part; cameras
    are listed by USB port so two identical ones never swap
    - docs/WIRING.md (pins, two supplies, shared ground) and docs/PI_SETUP.md
    Claude-Session: https://claude.ai/code/session_01Ks1AJqX4KiWSXEghkQfdCQ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
    [cli.py, hardware.py]
2026-10-24 Wiring diagram and a test script for every component
    - docs/wiring.png/.svg: Pi pins, two supplies, shared ground, servos,
    ULN2003 + stepper, cameras and light on USB
    - scripts/: test_servo (sweep + find angles by hand), test_stepper,
    test_cameras (by port, fps, focus score, --live), test_both_cameras,
    test_all (guided); all run with --fake off the Pi
    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
2026-10-25 Hardware PWM servos: wait for udev permissions after export
    Writing pwm0/enable right after exporting the channel failed with
    'permission denied' until udev hands the files to the gpio group; then the
    software-PWM fallback failed too, because the pin belongs to the PWM block.
    Wait (up to 3 s) for write access, and don't fall back when the overlay is
    active; explain the gpio group if access never comes.
    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
    [hardware.py]
2026-10-25 Servo pulse range matched to the MG90S in use (~220 deg on 0.5-2.4 ms)
    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
2026-10-25 Control panel: servos, stepper, machine moves and both cameras in one window
    Stepper moves ramp up and down so they can run faster than a flat start,
    only changed pins are written, and moves can be stopped. Angles, feed
    distance and speed save to ~/.sortbuddy/hardware.json for the machine.
    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
2026-10-25 Control panel cameras: 15 fps, reconnect a stalled camera, clean exit
    Two MJPG cameras at 30 fps were dropping data and freezing; 15 fps halves
    the USB load. A camera that sends nothing for 3 s is reopened, and the
    camera threads finish before exit (no more abort on close).
    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
    [control.py]
2026-10-25 Skip camera frames cut short over USB; measure how often it happens
    Frames that lose data over USB decode with a flat grey bottom. They're now
    detected and skipped (control panel and the app's camera reads), the panel
    counts them and hides libjpeg's warning flood, and test_both_cameras.py
    --modes measures broken frames per camera alone, together and at smaller
    sizes to find the cause.
    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
    [camera.py, control.py, test_both_cameras.py]
2026-10-25 Panel decodes only the camera frames it shows; one entry per USB camera
    The camera test showed 0% broken frames with no window, so the breakage in
    the panel comes from load, not USB bandwidth. Frames are now grabbed
    nonstop but only decoded when the preview wants one (8 per second).
    usb_cameras() also skipped the Pi's codec/ISP devices and the duplicate
    -usbv2- links that newer systems add.
    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
    [cli.py, control.py]
2026-10-25 Control panel saves every setting change automatically
    Servo positions, stepper speed, feed distance and settle time save half a
    second after a change, and on close, so they're there next time the panel
    opens. The Save button is gone.
    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
2026-10-26 Printable 1:1 foam-board cutting template for the scan station
    Slide, acrylic window, upper and lower camera hoods, gate flap and servo
    cutout, stand wedges and base, for 5 mm board on A4, with tab-and-notch
    joints glued only from the outside. Generated by
    docs/build/make_foam_template.py.
    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
2026-10-26 Template: hopper and friction-wheel feeder; feeder runs forward only
    Pages 9-10: hopper box, front wall with an adjustable plastic throat strip,
    a foam wheel on the stepper under a slot in the hopper floor, the motor
    bracket and a stack weight. A wheel can't run backwards after each card,
    so Machine.feed only goes forward unless feed_return is set (for a pusher).
    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
2026-10-28 Workbench: personal kanban board page (published as an artifact)
    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
2026-11-04 Printable feed wheel, motor bracket, throat strip and gate flap (OpenSCAD + STL)
    Claude-Session: https://claude.ai/code/session_01FqQeAAsLXpmNJkPAsBzAXU
    [bracket.stl, flap.stl, sortbuddy_parts.scad, throat.stl, wheel.stl, wheel_big.stl]
2026-11-04 One-piece printable hopper that takes the printed bracket, wheel and throat strip
    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
    [hopper.stl, sortbuddy_parts.scad]
2026-11-04 Thin-wall hopper variant (2.4 mm walls, same inside dimensions)
    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
    [hopper.stl, hopper_light.stl, sortbuddy_parts.scad]
2026-11-04 Printable one-piece slide and stack weight
    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
    [slide.stl, sortbuddy_parts.scad, weight.stl]
2026-11-05 Printable MG90S servo mount for the gate and sorter servos
    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
    [servo_mount.stl, sortbuddy_parts.scad]
2026-11-05 Printable camera mount for the 26 x 10.5 mm USB camera boards
    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
    [camera_mount.stl, sortbuddy_parts.scad]
2026-11-05 Printable one-piece lower hood with window ledge and camera locator
    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
    [lower_hood.stl, sortbuddy_parts.scad]
2026-11-05 LED diffuser channel for an 8 mm strip (120 and 60 mm)
    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
    [led_channel.stl, led_channel_short.stl, sortbuddy_parts.scad]
2026-11-07 Printable splices H and joiners J, plus a one-plate set
    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
    [joiner.stl, joints.stl, sortbuddy_parts.scad, splice.stl]
2026-11-07 Printable hood plates E and F with camera-mount recesses
    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
    [plate_E.stl, plate_F.stl, sortbuddy_parts.scad]
2026-11-07 Printable lower hood panel D (same as D1/D2)
    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
    [panel_D.stl, sortbuddy_parts.scad]
2026-11-07 Feeder exploded-view drawing, built from the printable parts
    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
    [feeder_exploded.scad]
2026-11-07 Feeder drawing: screw sizes for the motor, bracket and throat strip
    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
2026-11-07 Feeder drawing: motor screw stack and wheel gap that clears the screw heads
    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
2026-11-07 Feeder drawing: throat strip screw heads inside, nuts outside
    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
2026-11-07 Feeder drawing: screws, washers and nuts in the exploded view, plus close-ups of each screw stack
    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
    [feeder_exploded.scad]
2026-11-07 Wheel with a 3 mm spacer hub that clears the motor's ear screws
    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
    [sortbuddy_parts.scad, wheel_spaced.stl]
2026-11-07 Feeder drawing: spaced wheel, bracket screws M3 x 8 with 2 washers
    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
    [feeder_exploded.scad]
2026-11-07 Fix motor bracket: motor hole mirrored so it sits under the wheel slot; larger flange holes
    The drawing placed the bracket with a reflection, which hid that the real
    part, turned into place, puts the motor 14 mm off the slot centre.
    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
    [bracket.stl, feeder_exploded.scad, sortbuddy_parts.scad]
2026-11-07 Light motor bracket and spoked wheel: about half the filament each
    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
    [bracket.stl, bracket_lite.stl, feeder_exploded.scad, sortbuddy_parts.scad, wheel_lite.stl, wheel_spaced.stl]
2026-11-07 Frame hopper: thin walls, 45 mm tall, peaked self-supporting windows (~58 cm3 vs 86)
    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
    [hopper_frame.stl, sortbuddy_parts.scad]
2026-11-07 Hoppers: deep finger slots on both sides to pinch the stack out
    Replaces the shallow top notches. The slots stop 5 mm above the floor so the
    bottom card is fed past unbroken walls.
    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
    [hopper.stl, hopper_frame.stl, hopper_light.stl, sortbuddy_parts.scad]
2026-11-07 Light bracket without the side window
    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
    [bracket_lite.stl, sortbuddy_parts.scad]
2026-11-07 Take-away rollers on the slide: second wheel and motor under a new slide, sprung roller on top
    The feed wheel alone leaves each card's tail pinned under the stack. A second
    28BYJ-48 under the slide (on a second ULN2003 wired to the same GPIO pins)
    with a free roller pressing down pulls the card fully out. Default feed
    distance raised to 4500 half-steps to carry a card past the take-away.
    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
    [bracket_lite.stl, slide_takeaway.stl, sortbuddy_parts.scad, takeaway_axle.stl, takeaway_bracket.stl, takeaway_roller.stl]
2026-11-07 Light take-away slide: 2.4 mm walls, low except at the roller and the hood end (~41 cm3 vs 71)
    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
    [slide_takeaway_lite.stl, sortbuddy_parts.scad]
2026-11-07 Take-away roller as three short pieces: a tall thin tube gets knocked over on a bed-slinger
    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
    [sortbuddy_parts.scad, takeaway_rollers.stl]
2026-11-07 Belt-driven take-away: one motor drives both wheels through equal pulleys and a rubber band
    Feed wheel with a pulley and a separate spacer ring, a free take-away wheel
    on a printed axle in a frame glued under the slide. Assembly checked for
    collisions (docs/build/print/belt_check.scad).
    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
    [belt_axle.stl, belt_check.scad, belt_frame.stl, belt_spacer.stl, belt_wheel_feed.stl, belt_wheel_takeaway.stl, sortbuddy_parts.scad]
2026-11-07 Belt frame: flat glue tabs for the underside of the slide floor
    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
    [belt_frame.stl, sortbuddy_parts.scad]
2026-11-09 Picture: how the take-away roller's rubber bands hook on
    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
    [roller_band_view.scad]
2026-11-09 Belt frame: drop the hopper-end crossbar, it sat inside the belt loop
    A closed band could not be put on around it. Frame is now a U open toward
    the hopper; band goes on the take-away pulley before the axle.
    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
    [belt_frame.stl, sortbuddy_parts.scad]
2026-11-10 Elevator feeder concept: top-pick box with rising floor, swappable roller and suction heads, review page
    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
    [elevator_concept.scad]
